robertbowerman/WheelMarkI/3D Printer Fail on Sawing Jig.jpg

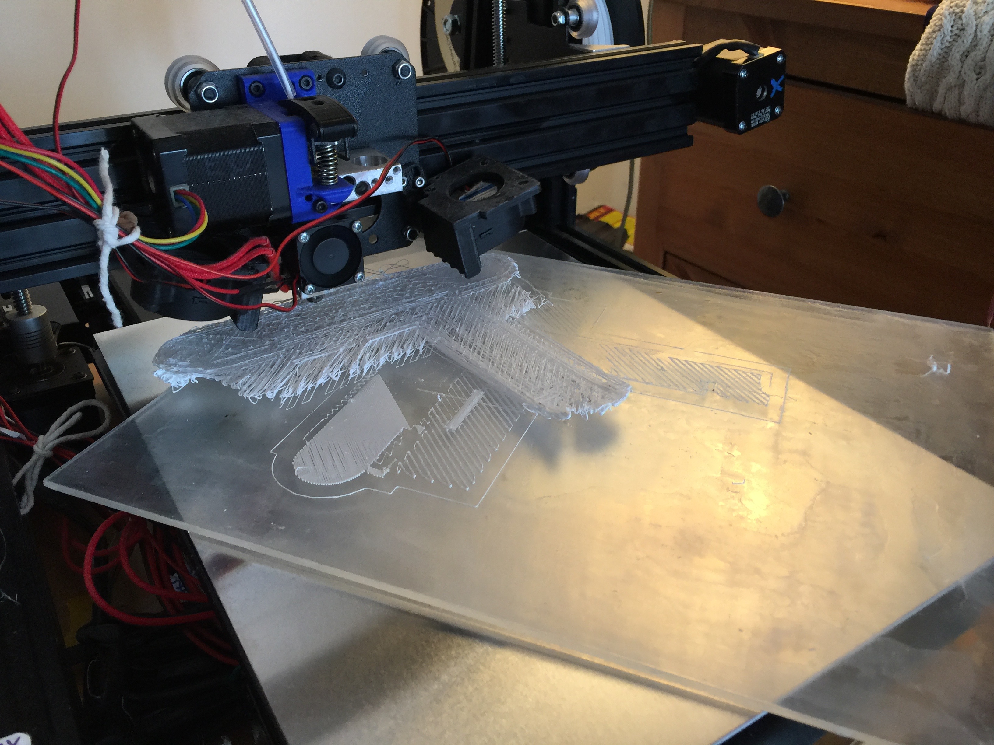
3D Printer Fail on Sawing Jig.jpg
