robertbowerman/WheelMarkI/Geometry/Snapshot Optical Circuit IMG_7917.jpg

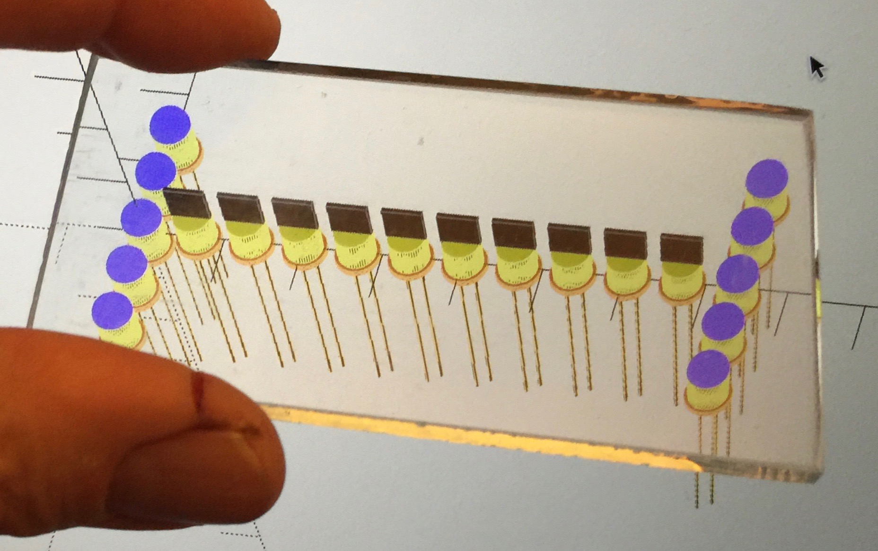
Geometry/Snapshot Optical Circuit IMG_7917.jpg
