robertbowerman/WheelMarkI/README.md

# WheelMarkI
Wheel Mark I is a brushless direct current motor (BLDC) residing in the hub of a wheel.  The functionality includes the vehicle traction motor.
