robertbowerman/WheelMarkI/Circuitry/High Voltage Circuit map to Vero.graffle/image1.pdf

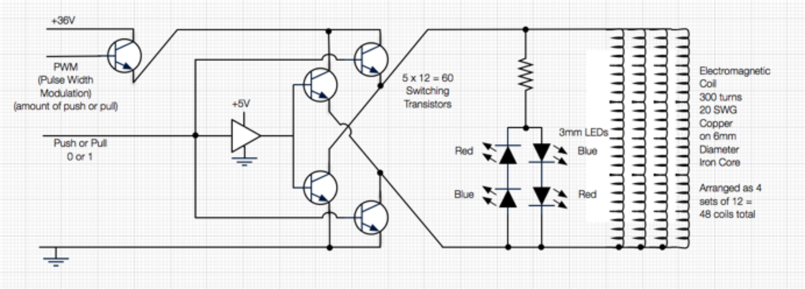
[picture p4: page 1]
