robertbowerman/WheelMarkI/!Sawing Jig Work in Progress.jpg

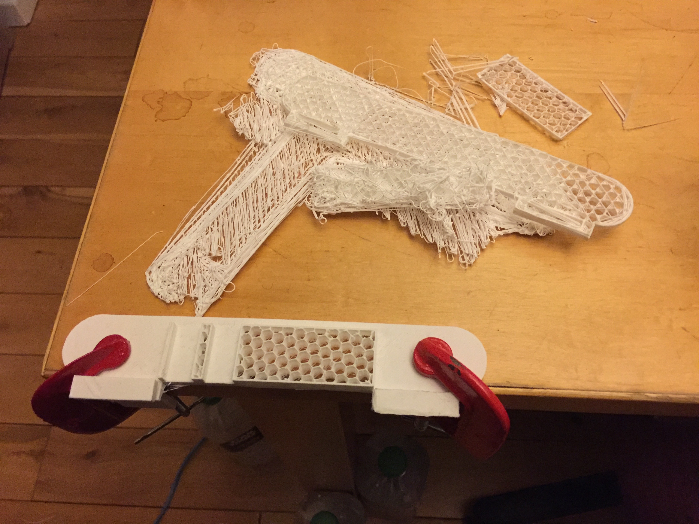
!Sawing Jig Work in Progress.jpg
