robertbowerman/WheelMarkI/Circuitry/Bike Motor Circuitry.graffle/image1.jpg

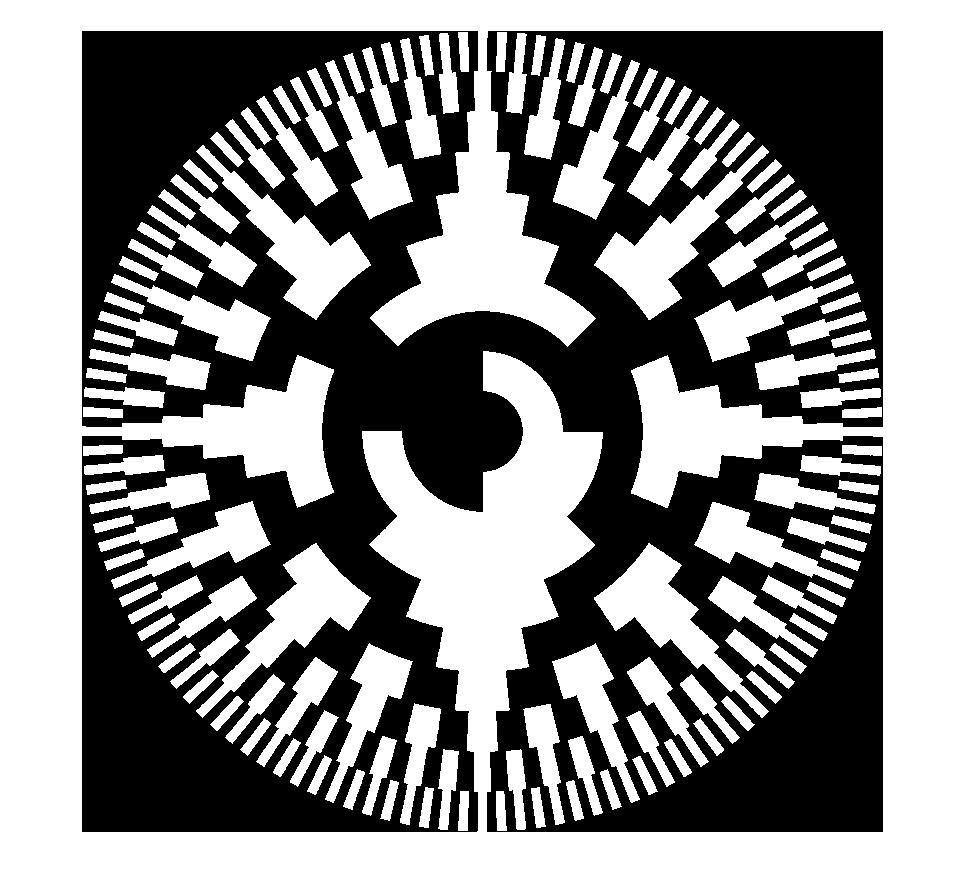
Circuitry/Bike Motor Circuitry.graffle/image1.jpg
