robertbowerman/WheelMarkI/Circuitry/current mesurement pic arduino for dummies.png

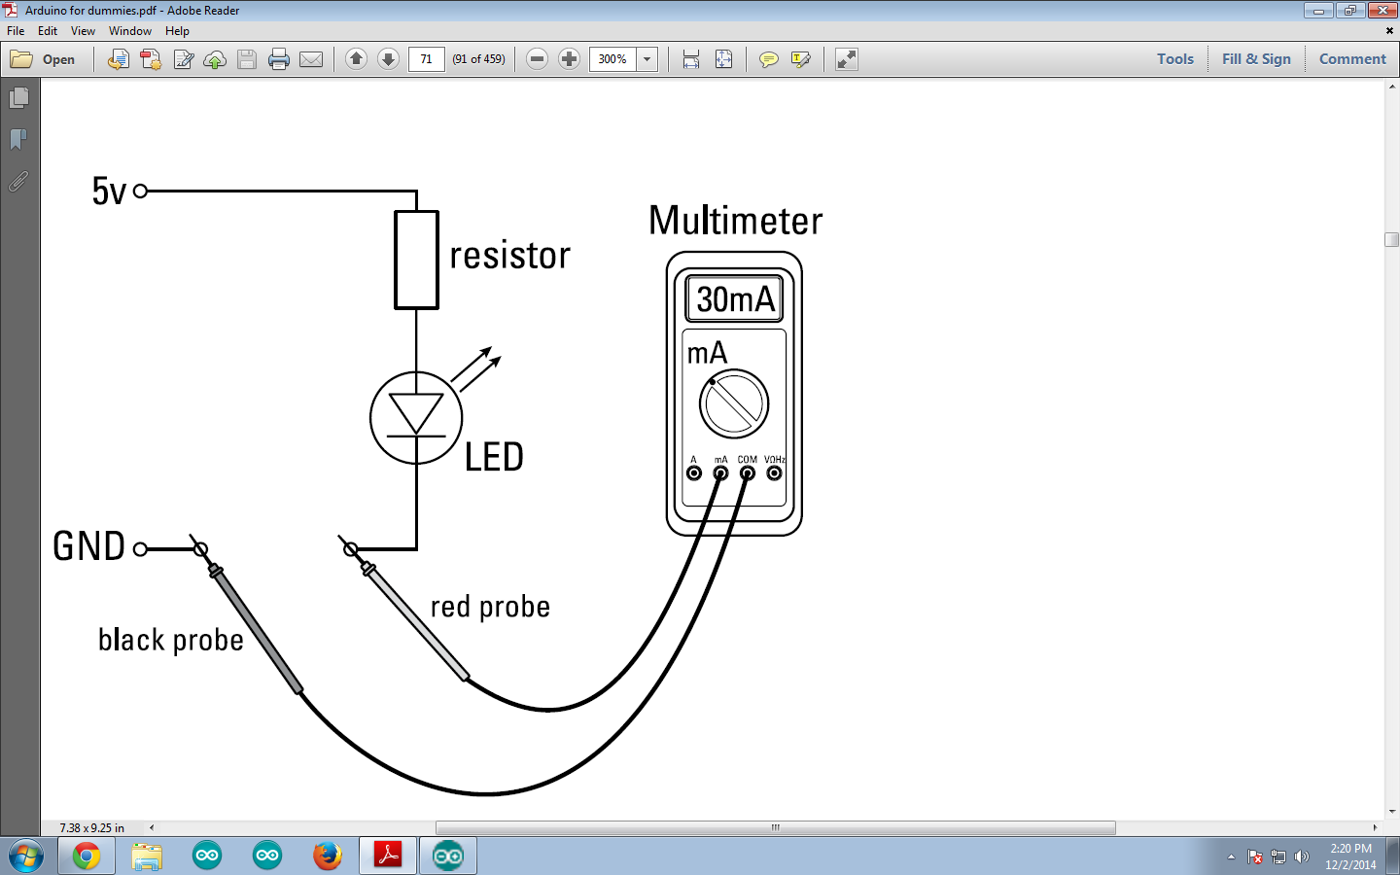
Circuitry/current mesurement pic arduino for dummies.png
