robertbowerman/WheelMarkI/Concept/Traction Wheel High Level Design  more good.graffle/image2.jpg

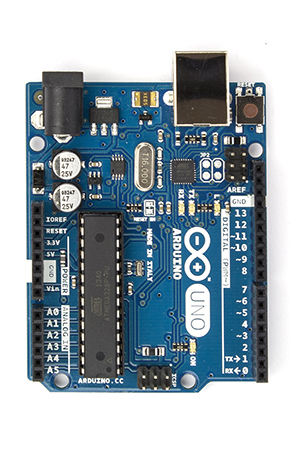
Concept/Traction Wheel High Level Design more good.graffle/image2.jpg
