robertbowerman/WheelMarkI/Geometry/Snapshot fit in biscuit tin IMG_7912.jpg

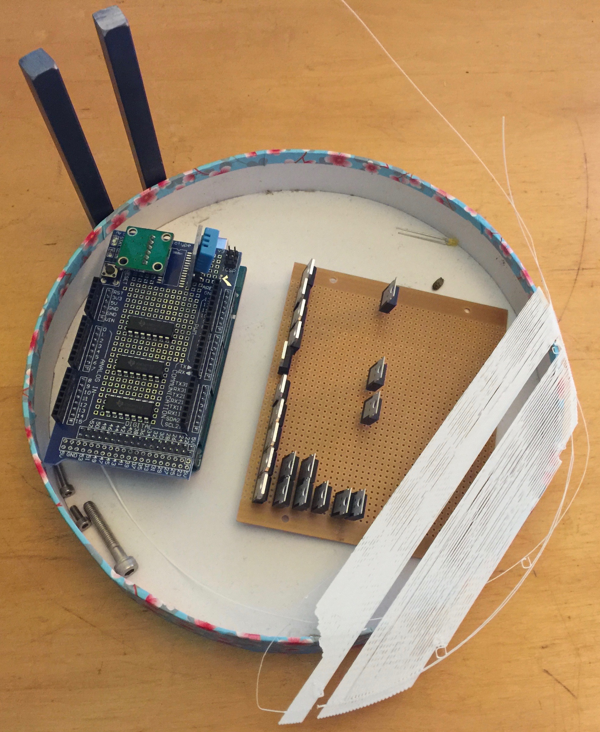
Geometry/Snapshot fit in biscuit tin IMG_7912.jpg
