robertbowerman/WheelMarkI/Geometry/Snapshot Magnetic Circuit 8 Feb 16 IMG_7915.jpg

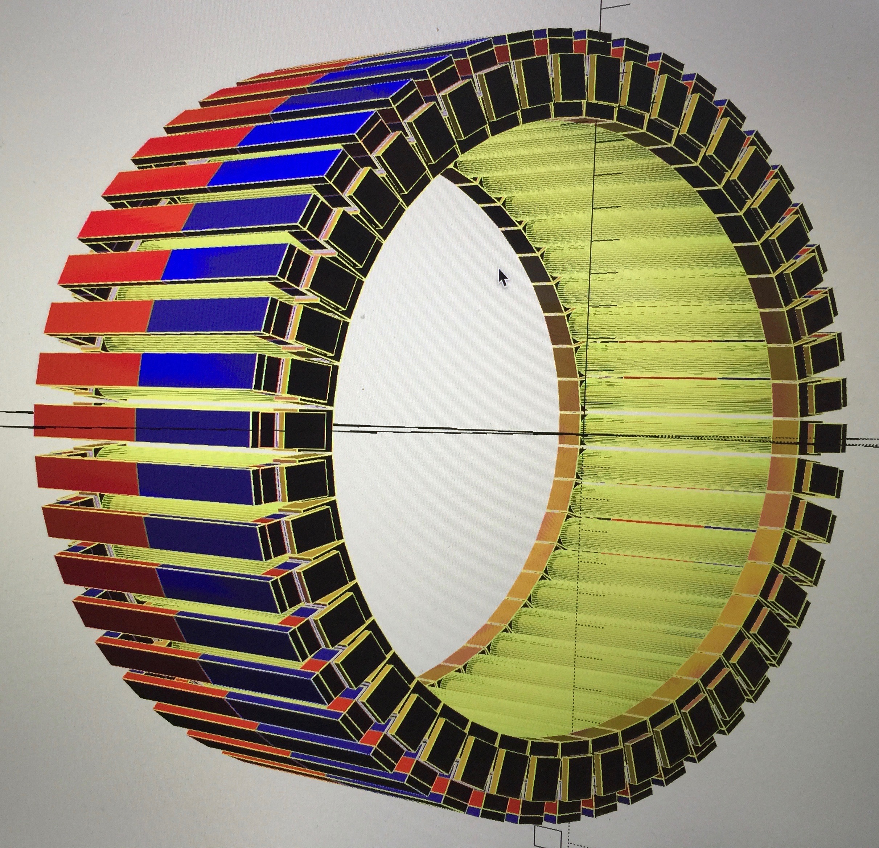
Geometry/Snapshot Magnetic Circuit 8 Feb 16 IMG_7915.jpg
