robertbowerman/WheelMarkI/Geometry/Snapshot Stator8 Feb 16 IMG_7914.jpg

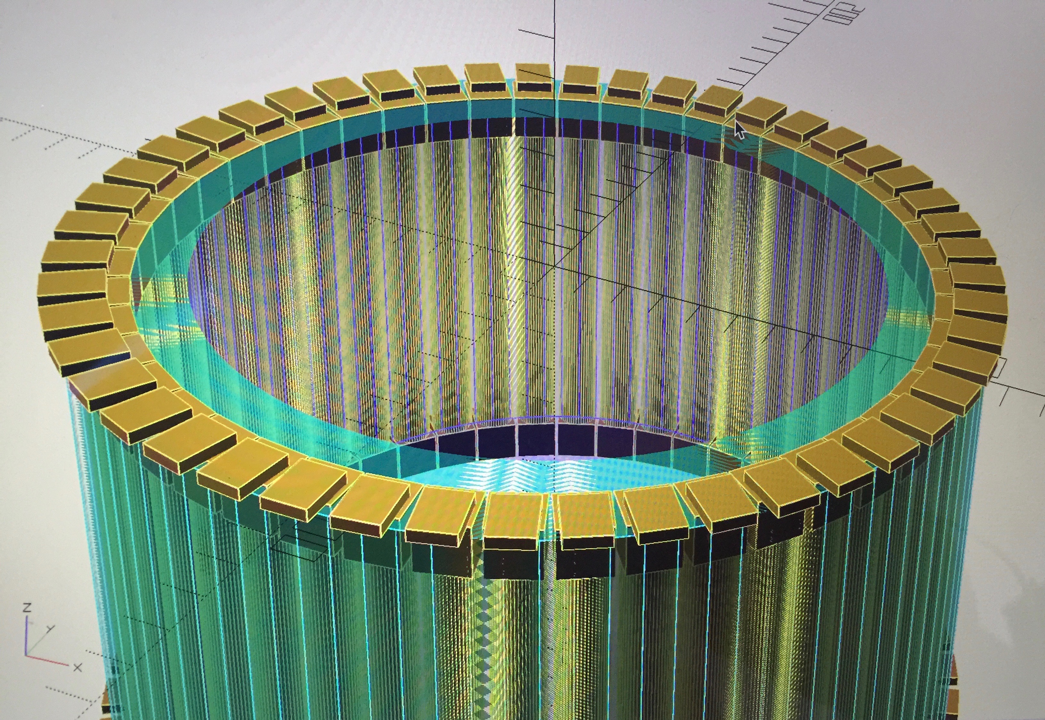
Geometry/Snapshot Stator8 Feb 16 IMG_7914.jpg
