robertbowerman/WheelMarkI/Assembly/Wheel Bill of Materials Cost Weight.xlsx

This spreadsheet excludes shipping, as that decreases with volume a lot. It includes VAT. Or should it? | Pack Price | Pack Qty | Unit of Measure | Unit Price | Wheel Qty | Unit of Measure | Packs to Order | Wheel Price | Packs to Order per Car |  | Car Price | Supplier | Shipping | Date of Order | Ship From
12mm x 12mm x 12mm Pads, cut of 1mm | £1.99 | 1 | mm | £1.99 | 1248 | mm | 2 | £3.98 | 4992 | mm | £9.96 | Metalbits
10mm x 3mm Side Pads & Top Circuit, cuts of 3mm. Order qty is 1m | £0.7080 | 1 | mm | £0.71 | 7248 | mm | 8 | £5.66 | 28992 | mm | £20.53
6mm rod x 100mm, cut of 1mm | £0.60 | 1 | mm | £0.60 | 4848 | mm | 5 | £3.00 | 19392 | mm | £12.00
Metalbits Subtotal for one wheel, one car |  |  |  |  |  |  |  | £12.65 |  |  | £42.49
M3 Inserts |  |  |  |  |  |  |  |  |  |  |  | RS |  |  | UK
Bolts to hold lid on, Red Aluminium Hex M8x50 (They are used wherever there is high voltage under a cover) | £4.74 | 6 |  | £0.79 | 12 |  |  | £9.48 |  |  |  | Amazon | £7.99 | 2016-01-22 | China
Nuts for the lid to attach to M8, get embedded
Copper Wire 20SWG, 0.9mm diam, 250g price | £7.72 | 42500 | mm | £0.00018 | 361911.4737 | mm | 9 | 69.48 |  |  |  | Maplin |  | 2016-01-22 | UK
Maplin Subtotal for one wheel, one car |  |  |  |  |  |  |  | £69.48 |  |  | £0.00
