robertbowerman/WheelMarkI/Concept/BOM - Bill of Materials - Requirements - Tests.xlsx

Sheet: BOM
KlimaProtekta Part ID No | KlimaProtekta Traction Part Description | Commercial Source | Catalogue Price £ | Denomination of Quantity (DoQ) | Unit Price £ | Quantity in One 64EM | 8EM Extended Preice £ | Quantity of above in One Car | Car Extended Preice £ | Purchased | 3D Printed | Width mm | Depth mm | Height mm | Weight grams | Volume Litres | Material Made of | Cost including VAT | Comment
Bike-Motor-Part-01 | Stator Body |  |  |  |  | 1 |  | 1 |  | No | Yes |  |  |  |  |  | Nylon
Bike-Motor-Part-02 | Stator Lid |  |  |  |  | 1 |  | 1 |  | No | Yes |  |  |  |  |  | Nylon
Bike-Motor-Part-03 | Stator Lid Seal |  |  |  |  | 1 |  | 1 |  | No | Yes |  |  |  |  |  | Nylon or PETE
 | Stator Light Tower
 | Stator Bike Adapter
 | Stator 400V Triac Cover
 | Stator 400V Copper Sleeve
 | Rotor
Bike-Motor-Part-04 | Rotor |  |  |  |  | 1 |  | 1 |  | No | Yes |  |  |  |  |  | Nylon
Bike-Motor-Part-05 | Position Sensor Greys Disk |  |  |  |  | 1 |  | 1 |  | No | Yes |  |  |  |  |  | Black PLA
Bike-Motor-Part-06 | Stator-to-Stator Bolts
Bike-Motor-Part-07 | Stator-to-Stator Nuts
Bike-Motor-Part-08 | Stator-to-Stator Washers
Bike-Motor-Part-09 | Permanent Magnets (Traction) | First4Magnets |  |  | £1.17 | 64 | £74.88 | 4 | £299.52 | Yes |  | 10 | 10 | 10 |  | 0.0010
Bike-Motor-Part-10 | Electromagnetic Cores (Traction) |  |  |  |  |  | £0.00 |  | £0.00 |  | Yes | 1 | 1
Bike-Motor-Part-11 | Copper Wire 1mm SWG 19 250g | Maplin | £8.49 | 1 | £8.49 | 8 | £67.92 | 4 | £271.68 | Yes | No
Bike-Motor-Part-12 | Arduino Mega 2560 Rev 3 | Amazon | £30.85 | 1 | £30.85 | 1 | £30.85 | 4 | £123.40 | Yes | No | 101.52 | 53.30 |  | 37
Bike-Motor-Part-13 | Thyristors |  |  |  |  |  |  |  |  | Yes
Bike-Motor-Part-14 | Lithium Ion 86150 Batteries |  |  |  |  |  |  |  |  | Yes
Bike-Motor-Part-15 | Phototransistors
 |  |  |  |  |  |  | £173.65 |  | £694.60
 | Nylon Filament Natural Colour
 | PLA Filament Black Colour
 | Overall Plastic Needed
 | Overall Weight for One Wheel

Sheet: Principles
Tweaks | We will be improving our design incrementally through a large number of tweaks or improvements.
Inventory | We will hold not much inventory at all as our design is likely to keep changing, so don’t buy components that may not be used.

Sheet: Requirements
Requirement
This bike motor has no parking brake in it.
The motor is designed to operate at 37 volts
The stator needs to be printed in two parts so that it can close like a clam shell around the rotor and encase it in field so as to avoid ball bearings.
The aim of this prototype is to use electromagnets that are identical to the ones in the 64 EM design.
The Electromagnets produce field pads of 1 cm x 1cm, one each for North and South
The Electromagnets produce field pads of 0.5cm x 1cm, one each for North and South, at right angles to the main 1cm2 pads - in order to provide ball bearing-free bearing effect.
The air gap of the motor is 1mm
The permanagent magnets are encased in a layer of 1mm of nylon between them and the air gap.
The electromagnets are encased in a layer of 1mm of nylon between them and the air gap.
The electromagnetic coil is 100mm long
The part of the core that the coil is wound on is 3mm radius.
The copper wire used to wind the electromagnets is 1mm in diameter.
The coil is to be wound in two layers
There must be enough room inside the motor for the controller board & supporting electronics
The controller board is to be an Arduino Uno
Each electromagnet must be switchable under software control to three states: Off, North Up, North Down.
The power flowing through the coils is to be assumed to be too much for the Arduino itself and thus need independent switching.
Thyristors are to be used for the coil switching
There are four thyristors per coil to achive the 3 states
This bike motor is to be used for electromagnetic traction.
This bike motor is to be used for electromagnetic braking.
Upon braking, as much energy as possible is to be returned to the batteries.
The batteries must have room to hold the power from braking.
The batteries must be able to handle the voltage arising from braking.
The batteries must be able to handle the current arising from braking.
Arduino Uno has 14 digital I/O pins (6 of which usable as PWM o/p)
Arduino Uno has 6 analogue input pins.
The system shall be able to determine which of 8 positions the rotor is at.
The system shall be able to determine 4 intermediate positions between the 8 electromagnetics.
[So the total positions to monitor are 32 positions, which means 5 bits of greys disk] Input.
[Plus temperature monitoring means a minimum of 6 analogue inputs]
The system needs to be able to control 2 bits for each of the 8 electromagnets, plus 1 PWM channel with 2 bits for power.
[Which means 9 x 2 = 18 bits of digital output. i.e. Not the Uno].
The test will involve measuring the temperature inside the motor while it is running.
The test will involve measuring the voltage going to the motor while it is running.
The test will involve measuring the current going to the motor while it is running.
The test will involve determining the distance that the motor can move the bike starting with a known amount of kWh of energy.
The test will involve determining the speed that the motor can move the bike at.
The test will involve determining the acceleration that the motor can make the bike move with.
The test will involve determining the deacceleration that the motor can make the bike move with.
The test will involve determining the stopping distance that the motor provides to the bike given a known starting speed.
The test will involve determining the stopping time that the motor provides to the bike given a known starting speed.
The test will evaluate the effect of PWM on power to the road.
The test will evaluate the effect of input traction voltage from the main battery pack on power to the road.

Sheet: Derived
Input and Calculated Values (where input is requirement) | Requirement | Derived | Vendor Sheet | Comment
Coil Core Radius (mm) | 3
Coil Core Diameter (mm) |  | 6
Coil Wire Diameter (mm) | 0.9 |  |  | Maplin is actually 0.9mm
Coil Layer One Diameter (mm) |  | 6.9
Coil Layer One Circumference (mm) |  | 21.677
Core and thus Coil Length (mm) | 97.2
Turns achieved over length of coil per layer (Quantity) |  | 108 |  | 107 turns 96.3 length OK
Length of copper wire in layer one of coil (mm) |  | 2341.11
Number of Layers of coil (Quantity) | 2
Coil Layer Two Diameter (mm) |  | 8.7
Coil Layer Two Circumference (mm) |  | 27.332
Length of copper wire in Layer Two of coil (mm) |  | 2951.84
Length of copper wire lead from thyristor to core (mm), allow |  | 20
Number of lead wires per core (Quantity) |  | 2
Length of copper wire in lead wires (mm) |  | 40
Overall Length of Copper wire per coil (mm) |  | 5332.96
Density of This Enammelled Copper Wire
Weight of One Coil (grams)
Number of Electromagnetic Coils in this motor | 8
Overall Length of Copper wire per motor (mm) |  | 42663.64 |  | Used from one Reel
Length of 1mm Enamelled Copper Wire on 1 Reel from Maplin |  |  | 42500.00 | Reel
Number of Reels of 1mm Enamelled Copper Wire to Buy |  | 1.0
Volume of one core
Arduino Uno Size - Length (mm) | 53.4
Arduino Uno Size - Width (mm) | 68.6

Sheet: Arduino Choice
Capable of 18 bits of output with 2 of them PWM are Due, Leonardo, Mega 2560, Mega ADK, Micro and Yun. Filtering that for at least 5 bits of analogue input are 12 for Due, Leonardo and Micro and Yun, 16 for Megas,
Need |  | 6 | 18 | 2 |  |  |  |  | Price £ inc VAT
 | MHz | Analogue In | Digital Out | PWM | Width mm | Depth mm | Height mm | Weight grams | Amazon | Maplin | RS | Arduino Store
Due | 84 | 12 | 54 | 12
Leonardo | 16 | 12 | 20 | 7
Mega 2560 | 16 | 16 | 54 | 15 |  |  |  |  | £30.86 | £39.99 | N/A | £46.84
Mega ADK (R3 for Android) | 16 | 16 | 54 | 15 |  |  |  |  | £44.45 | £49.99 | N/A
Micro | 16 | 12 | 20 | 7
Yun | 16/400 | 12 | 20 | 7
not enough digital I/O - Uno | 16 | 6 | 14 | 6
Arduino Mega Proto Shield Rev 3 (PCB) |  |  |  |  |  |  |  |  |  |  |  | £4.68
Humidity and Temperature Sensor
Accelerometer
Range Distance Finder
