robertbowerman/WheelMarkI/Concept/Traction Wheel High Level Design 1.xlsx

Sheet: Sheet1
Name - 2D View | X Across mm | Y Down mm | Width mm | Height mm | Angle Deg | Model Colour | Thickness mm | Material | Sourcing | Comment | Function
Stator Cover | 20 | 20 | 286 | 286 | 0 | Pale Blue | 3 | PETE - Δ1 | Recycled Plastic | Roughly Cylindrical Shape | Waterproof
Nylon Stator outer layer | 23 | 23 | 280 | 280 |  | Pale Green | 6 | Nylon |  |  | Strength
Electomagetic Core Keyhole Shape | 29 | 29 | 268 | 268 |  | Red or Blue | 10 | Core |  |  | Force Generation
Nylon Stator Inner Layer | 39 | 39 | 248 | 248 |  | Pale Green | 1 | Nylon |  |  | Stop Scraping
Air Gap | 40 | 40 | 246 | 246 |  | Marigold | 1 | Air Gap |  |  | Air Gap
Rotor outer wall | 41 | 41 | 244 | 244 |  | Pale Green | 2 | Nylon |  |  | Hold Magnets In
Permanent Magnets, Ring of | 43 | 43 | 240 | 240 |  |  | 10 | Magnet |  |  | Force Generation
Rotor inner wall outer | 53 | 53 | 220 | 220 |  | Pale Green | 6 | Nylon
Rotor inner wall inner | 59 | 59 | 208 | 208 |  |  | 0
Core of Coil 1 Top Most Noon | 158 | 29 | 10 | 10 | 0
Core of Coil 2
Permanent Magnet 1 Top Most Noon | 158 |  | 10 | 10 | 0
Central Nut Hub | 148 | 148 | 30 | 30 |  |  |  | Nylon
Hold Stator On Security Bolt | 160 | 160 | 6 | 6
Wheel Centre on Drawing | 163 | 163

Sheet: Grey's Disk
Ring Number from Outside (outermost is 1) | Number of Slices in this Ring | Number Black | Number of White (holes) | States Distinguishable Between | Position Numbers Range From | Position Numbers Range To | Degrees Per Slice (be it black or white)
1 | 2 | 1 | 1 | 2 | 0 | 1 | 180
2 | 4 | 2 | 2 | 4 |  |  | 90
3 |  |  |  |  |  |  | 45
4 |  |  |  |  |  |  | 22.5
5 |  |  |  |  |  |  | 11.25
6 |  |  |  |  |  |  | 5.625
7 |  |  |  |  |  |  | 2.8125
8 |  |  |  |  |  |  | 1.40625
9 |  |  |  |  |  |  | 0.703125
10 |  |  |  |  |  |  | 0.3515625
