robertbowerman/WheelMarkI/Geometry/MagneticCircuitJigMainBody.stl

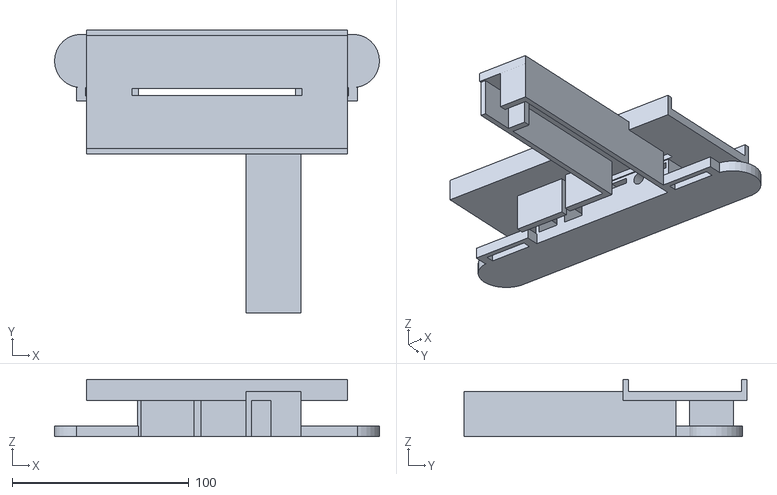
[picture p13: CAD file, 2016-02-02]
Geometry/MagneticCircuitJigMainBody.stl
184.0 x 160.1 x 32.5
