robertbowerman/WheelMarkI/Geometry/MagneticCircuitJigTableEdgeStop.stl

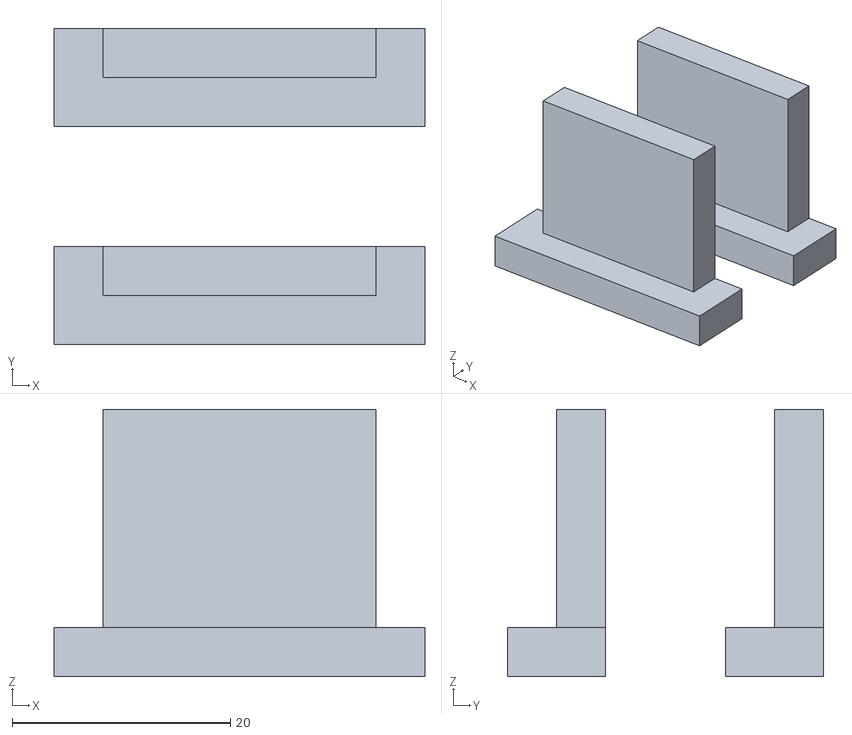
[picture p14: CAD file, 2016-01-29]
Geometry/MagneticCircuitJigTableEdgeStop.stl
34.0 x 29.0 x 24.5
