robertbowerman/WheelMarkI/Geometry/MagneticCircuitJigStockSupport.stl

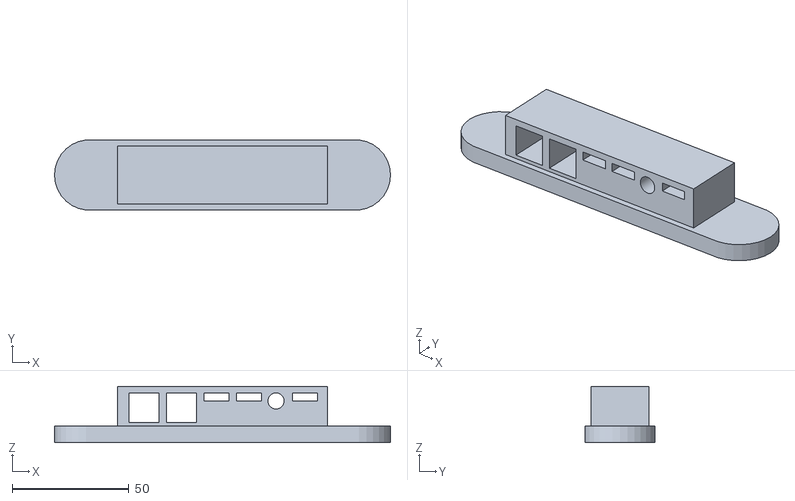
[picture p15: CAD file, 2016-01-23]
Geometry/MagneticCircuitJigStockSupport.stl
144.0 x 30.0 x 24.0
