robertbowerman/WheelMarkI/Geometry/MagneticCircuitJigBackStop.stl

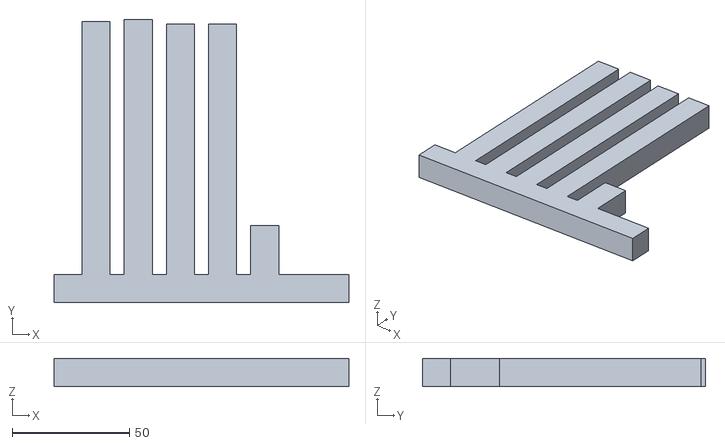
[picture p16: CAD file, 2016-01-22]
Geometry/MagneticCircuitJigBackStop.stl
126.0 x 121.0 x 12.0
