robertbowerman/WheelMarkI/(list of files, cad)

Other CAD files:
Geometry/MagneticCircuitJigStockSupport2.AMF
Geometry/superseded/MagneticCircuitJigBackStop copy.stl
Geometry/Magnetic Circuit Jig Body README.scad
Geometry/Magnetic Circuit Jig for Metal Cutting with Dimensions README.scad
Geometry/MagneticCircuitJigBackStop2.scad
Geometry/MagneticCircuitJigforMetalCuttingwithDimensionsREADME.scad
Geometry/MagneticCircuitJigBackStop.AMF
Geometry/MagneticCircuitJigMainBody.AMF
Geometry/MagneticCircuitJigStockSupport.AMF
Geometry/MagneticCircuitJigTableEdgeStop.AMF
Geometry/superseded/Magnetic Circuit Jig Body README.scad
Geometry/superseded/MagneticCircuitJigBackStop.AMF
Geometry/superseded/MagneticCircuitJigBackStop1.scad
Geometry/superseded/MagneticCircuitJigMaterialSupport.scad
Geometry/superseded/MagneticCircuitJigStockSupport copy.scad
Geometry/superseded/MagneticCircuitJigStockSupport.scad
Geometry/superseded/MagneticCircuitJigStockSupport2.AMF
Geometry/superseded/MagneticCircuitMetalComponentsOld.scad
