robertbowerman/WheelMarkI/Assembly/Assembly Instructions for Traction SubSystem.docx

# Assembly Instructions for Traction SubSystem

Mark I is the Bike Motor, with 64 Electromagnets.

Steps of Work

# Tools to Gather Up or Purchase

1. 3D Printer with the following capabilities
  a. Required Print Volume:
  b. Two concurrent Print heads are required
  c. Hot End Temperature Capability
  d. Heat Bed Temperature Capability
2. Soldering Iron

# Raw Materials to Gather Up or Purchase

1. Filament for 3D Printing, 1.75mm Diameter
  a. Nylon (colourless)
  b. PETE
  c. Flexible
  d. Red
  e. Black
  f. White
2. Solder

# Parts to Purchase
