robertbowerman/WheelMarkI/Assembly/Assembly Instructions for Traction SubSystem.htm

Assembly Instructions for Traction SubSystem

Mark I is the Bike Motor, with 64 Electromagnets.

Steps of Work

# Tools to Gather Up or Purchase

1. 3D Printer with the following capabilities

a. Required Print Volume:

b. Two concurrent Print heads are required

c. Hot End Temperature Capability

d. Heat Bed Temperature Capability

2. 3D Printer tuning tools (list will depend upon your printer)

a. Allen keys (also known as Hex Keys)

b. Spanners (also known in USA as wrenches)

3. Soldering Iron

4. Digital Vernier Callipers – capable of measuring up to xx mm

5. Allen keys (also known as Hex Keys)

6. Wire Cutters

7. Wire Strippers

# Raw Materials to Gather Up or Purchase

1. Filament for 3D Printing, 1.75mm Diameter

a. Nylon (colourless)

b. PETE

c. Flexible

d. Red

e. Black

f. White

2. Solder

# Parts to Purchase

1. Magnets 10 mm x 10 mm x 10 mm

2. Magnets (for Hall Sensor) 1 mm x 10 mm x 10 mm

3. Enamelled Copper Wire, 20 SWG

4. Arduino Mega

5. Empty Shield for Arduino Mega

6. Circuit Board, Vero Board (for transistors)

7. Transistors

8. Resistors

9. LEDs

10. Photosensors

11. Microswitch

# Parts to 3D Print

# Assembly Instructions
