robertbowerman/WheelMarkI/Assembly/Jig for Metal Cutting.jpg

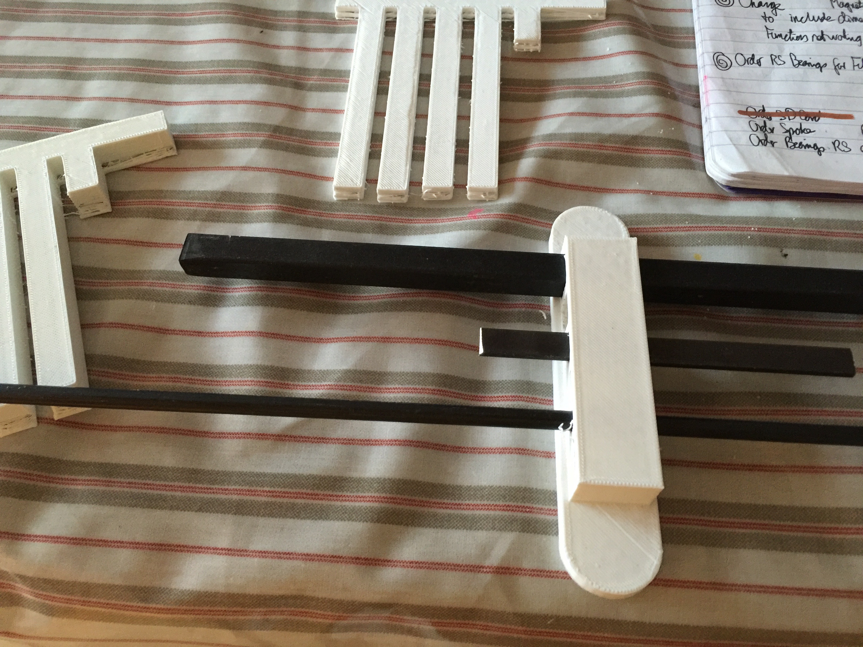
Assembly/Jig for Metal Cutting.jpg
