robertbowerman/WheelMarkI/Assembly/Magnetic Circuit Sketch.jpg

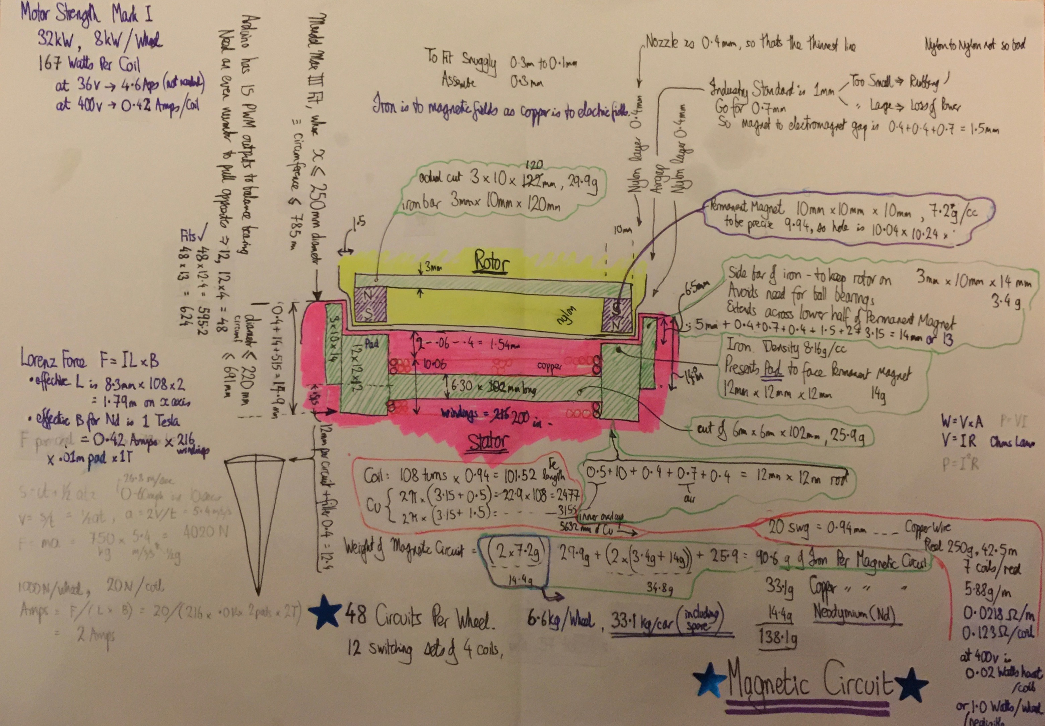
Assembly/Magnetic Circuit Sketch.jpg
