robertbowerman/WheelMarkI/(commit log)

2016-01-18 Magnetic Circuit Backstop
    maybe in wrong repository
    [Magnetic Circuit Jig Body README.scad, MagneticCircuitJigBackStop.scad, MagneticCircuitJigBackStop.stl, relativity2.scad]
2016-01-20 Jig for cutting cores - experiments with Relativity
    The layout of the six bars is v useful.
    [Magnetic Circuit Jig Body README.scad, MagneticCircuitJigMaterialSupport.scad]
2016-01-20 Magnetic Circuit Jig Stock Support
    There is another version called Material Support but its not as
    developed as this one. Use this one.
    [MagneticCircuitJigBackStop.AMF, MagneticCircuitJigStockSupport.scad]
2016-01-20 Merge of Wheel Mark 1 with Mk 1 earlier
    Added folders for Assembly Instructions, Context and so on.
    [BOM - Bill of Materials - Requirements - Tests.xlsx, Klima_Protekta_Traction_Circuitry.kicad_pcb, Klima_Protekta_Traction_Circuitry.sch, Traction Wheel High Level Design 1.xlsx]
2016-01-22 Updated Backstop for Cutting Jig
    For magnetic circuit, I updated the backstop to reflect the exact metal
    lengths of 121, 100, 14 and 12mm.
    [MagneticCircuitJigBackStop.scad, MagneticCircuitJigBackStop.stl]
2016-01-22 renamed backstop to avoid clash
    put a 2 on end, to ensure copy from big mac is kept and not overwritten
    by work on red laptop mac.
    [MagneticCircuitJigBackStop2.scad]
2016-01-22 Magnetic Circuit Refinements and Progress reports
    [Magnetic Circuit Jig Body README.scad, MagneticCircuitJigBackStop.scad, MagneticCircuitJigMaterialSupport.scad, MagneticCircuitJigStockSupport.scad, MagneticCircuitJigStockSupport2.AMF, MagneticCircuitJigStockSupport2.scad, MagneticCircuitJigStockSupport2.stl, MagneticCircuitMetalComponents.scad]
2016-01-23 Adding Bill of Materials and Refining Magnetic Circuit
    [Magnetic Circuit Jig Body README.scad, MagneticCircuitJigMaterialSupport.scad, Wheel Bill of Materials Cost Weight.xlsx]
2016-01-23 BackStop prints nicely, Stock Support ready for print
    Stock Support uses both Relativity and basic OpenSCAD. Its shuffled
    about by hand, not calculated in full - so there is room for
    improvement next time.
    [Magnetic Circuit Jig Body README.scad, Magnetic Circuit Jig for Metal Cutting with Dimensions README.scad, MagneticCircuitJigMaterialSupport.scad, MagneticCircuitJigStockSupport copy.scad, MagneticCircuitJigStockSupport.scad, MagneticCircuitJigStockSupport.stl, MagneticCircuitJigStockSupport2.AMF, MagneticCircuitJigStockSupport2.scad]
2016-01-25 Jig - Assembly, Magnetic Circuit, Stock Support, Main Body
    Getting chain of referrals on dimensions to work well. Realisation
    that circuit needs bolting in to keep it at the right end of its nylon
    hole.
    [MagneticCircuitJigMainBody.scad, MagneticCircuitJigStockSupport.scad, MagneticCircuitJigforMetalCuttingwithDimensionsREADME.scad, MagneticCircuitMetalComponents.scad, MagneticCircuitMetalComponentsInNylonHoles.scad, MagneticCircuitMetalInFull.scad, Wheel Bill of Materials Cost Weight.xlsx]
2016-01-25 AMF file for Stock Support
    [MagneticCircuitJigStockSupport.AMF]
2016-01-27 Developing Coil Protector and Coil Cover
    plus more on progress reports and back stops and jigs.
    [MagneticCircuitJigBackStop.scad, MagneticCircuitJigMainBody.scad, MagneticCircuitJigforMetalCuttingwithDimensionsREADME.scad, StatorCoilCover.scad, StatorCoilProtector.scad]
2016-01-29 Developing Jig with Relativity and Saw Plate
    [MagneticCircuitJigMainBody.scad, MagneticCircuitJigStockSupport.scad, MagneticCircuitJigTableEdgeStop.AMF, MagneticCircuitJigTableEdgeStop.scad, MagneticCircuitJigTableEdgeStop.stl, MagneticCircuitJigforMetalCuttingwithDimensionsREADME.scad, MagneticCircuitMetalComponentsInNylonHoles.scad]
2016-01-29 Firming up cutting jig with backstops integral and table edge
    making sure it can be printed without support.
    [MagneticCircuitJigBackStop copy.stl, MagneticCircuitJigBackStop.scad, MagneticCircuitJigMainBody.scad, MagneticCircuitJigMainBody.stl, MagneticCircuitJigStockSupport.scad, MagneticCircuitJigTableEdgeStop.scad, MagneticCircuitJigTableEdgeStop.stl]
2016-02-01 many refinements to jig and magnetic circuit
    Not magnetic circuit is refined on the big mac.
    [MagneticCircuitJigMainBody.AMF, MagneticCircuitJigMainBody.scad, MagneticCircuitJigMainBody.stl, MagneticCircuitJigStockSupport.AMF, MagneticCircuitJigTableEdgeStop.AMF, MagneticCircuitJigforMetalCuttingwithDimensionsREADMEOld.scad, MagneticCircuitMetalComponentsInNylonHolesOld.scad, MagneticCircuitMetalComponentsOld.scad]
2016-02-02 Stator Main Body coming on nicely
    Many refinements to Metal Components, Mental Components in Nylon Holes,
    Magnetic Circuit Full and Stator Main Body.
    [MagneticCircuitJigforMetalCuttingwithDimensionsREADME.scad, MagneticCircuitMetalComponents.scad, MagneticCircuitMetalComponentsInNylonHoles.scad, MagneticCircuitMetalInFull.scad, StatorMainBody.scad]
2016-02-03 Leveraging electronic component geometry from earlier
    [Klima_Protekta_Traction_Arduino_Mega_2560.scad, Klima_Protekta_Traction_Photosource_LED.scad, Klima_Protekta_Traction_Sensor_Hall_Effect_Magnetic_Field.scad, Klima_Protekta_Traction_Sensor_PhotoSensor.scad]
2016-02-04 Developing tower of light
    [Klima_Protekta_Traction_Photosource_LED.scad, Klima_Protekta_Traction_Sensor_PhotoSensor.scad, TowerOfLightAssembly.scad]
2016-02-05 Progress report and refined geometry
    [MagneticCircuitJigforMetalCuttingwithDimensionsREADME.scad, MagneticCircuitJigforMetalCuttingwithDimensionsREADMEOld.scad, MagneticCircuitMetalComponents.scad, MagneticCircuitMetalComponentsInNylonHoles.scad, MagneticCircuitMetalComponentsInNylonHolesOld.scad, MagneticCircuitMetalComponentsOld.scad, MagneticCircuitMetalInFull.scad, MagneticCircuitMetalInFullOld.scad]
2016-02-05 Refining Magnetic Circuit Metal In Full - for 121 being +0.34
    Metal cuts are exact integers, but the summation of stator parts isn’t
    an exact integer. so adjust.
    [MagneticCircuitMetalInFull.scad]
2016-02-05 Aligning magnetic circuit
    its the top bar 121 mm vs 100mm rod. Need to take into account the
    nylon air thickness at 0.3mm
    [MagneticCircuitMetalInFull.scad]
2016-02-11 Data Sheets on Accelerometer, Inverter, Shunt, Photos
    Accelerometer has 3 analogue outputs.
    [MagneticCircuitJigforMetalCuttingwithDimensionsREADME.scad]
2016-02-11 Recovered Lid from Backup, Sorted out Progrs Reports
    [Klima_Protekta_Traction_Stator_Lid.scad]
2016-02-11 Stator Body advancing, along with inserts and covers
    The biscuit tin ioutside is nicely lined up here - perforce.
    [BicycleWheelSpokes.scad, BrassInsertM3.scad, MagneticCircuitMetalInFull.scad, StatorCoilProtector.scad, StatorMainBody.scad]
2016-02-11 Coil Cover Inner and Outer. Inner is coil protector.
    [MagneticCircuitJigforMetalCuttingwithDimensionsREADME.scad, StatorCoilCover.scad, StatorCoilProtector.scad]
2016-03-07 Raffle of high voltage circuit - H-bridge
    mapping to Vero
2016-03-15 circuitry refinement & 13 Mar progress
    [TractionCircuit.kicad_pcb, TractionCircuit.sch]
2016-07-27 V=IR calculatio
    [Resistor Value Calculation.xlsx]
